MikeMcPherson/HEDGE2-OBC/CAD/CM4-spacer.FCStd

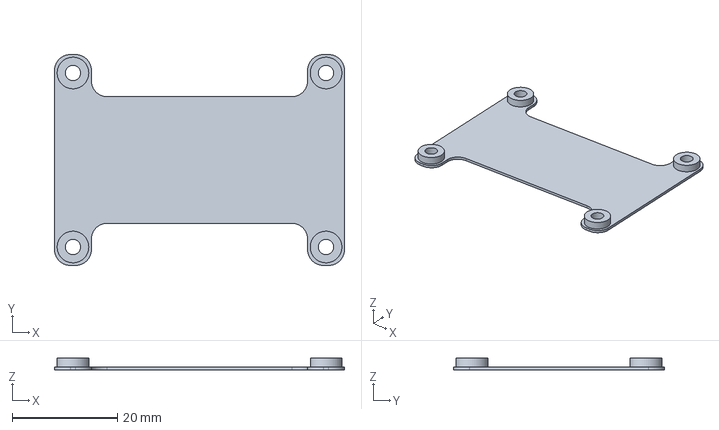
[picture p1: CAD file, 2026-04-15]
CAD/CM4-spacer.FCStd
55.0 x 40.0 x 2.30 mm
