MikeMcPherson/HEDGE2-OBC/(list of files, cad)

Other CAD files:
CAD/CM4-spacer.3mf
CAD/CM4-spacer.stl
