MikeMcPherson/HEDGE2-OBC/HEDGE2-OBC.kicad_pcb

## KiCad design HEDGE2-OBC.kicad_pcb (2025-12-07)

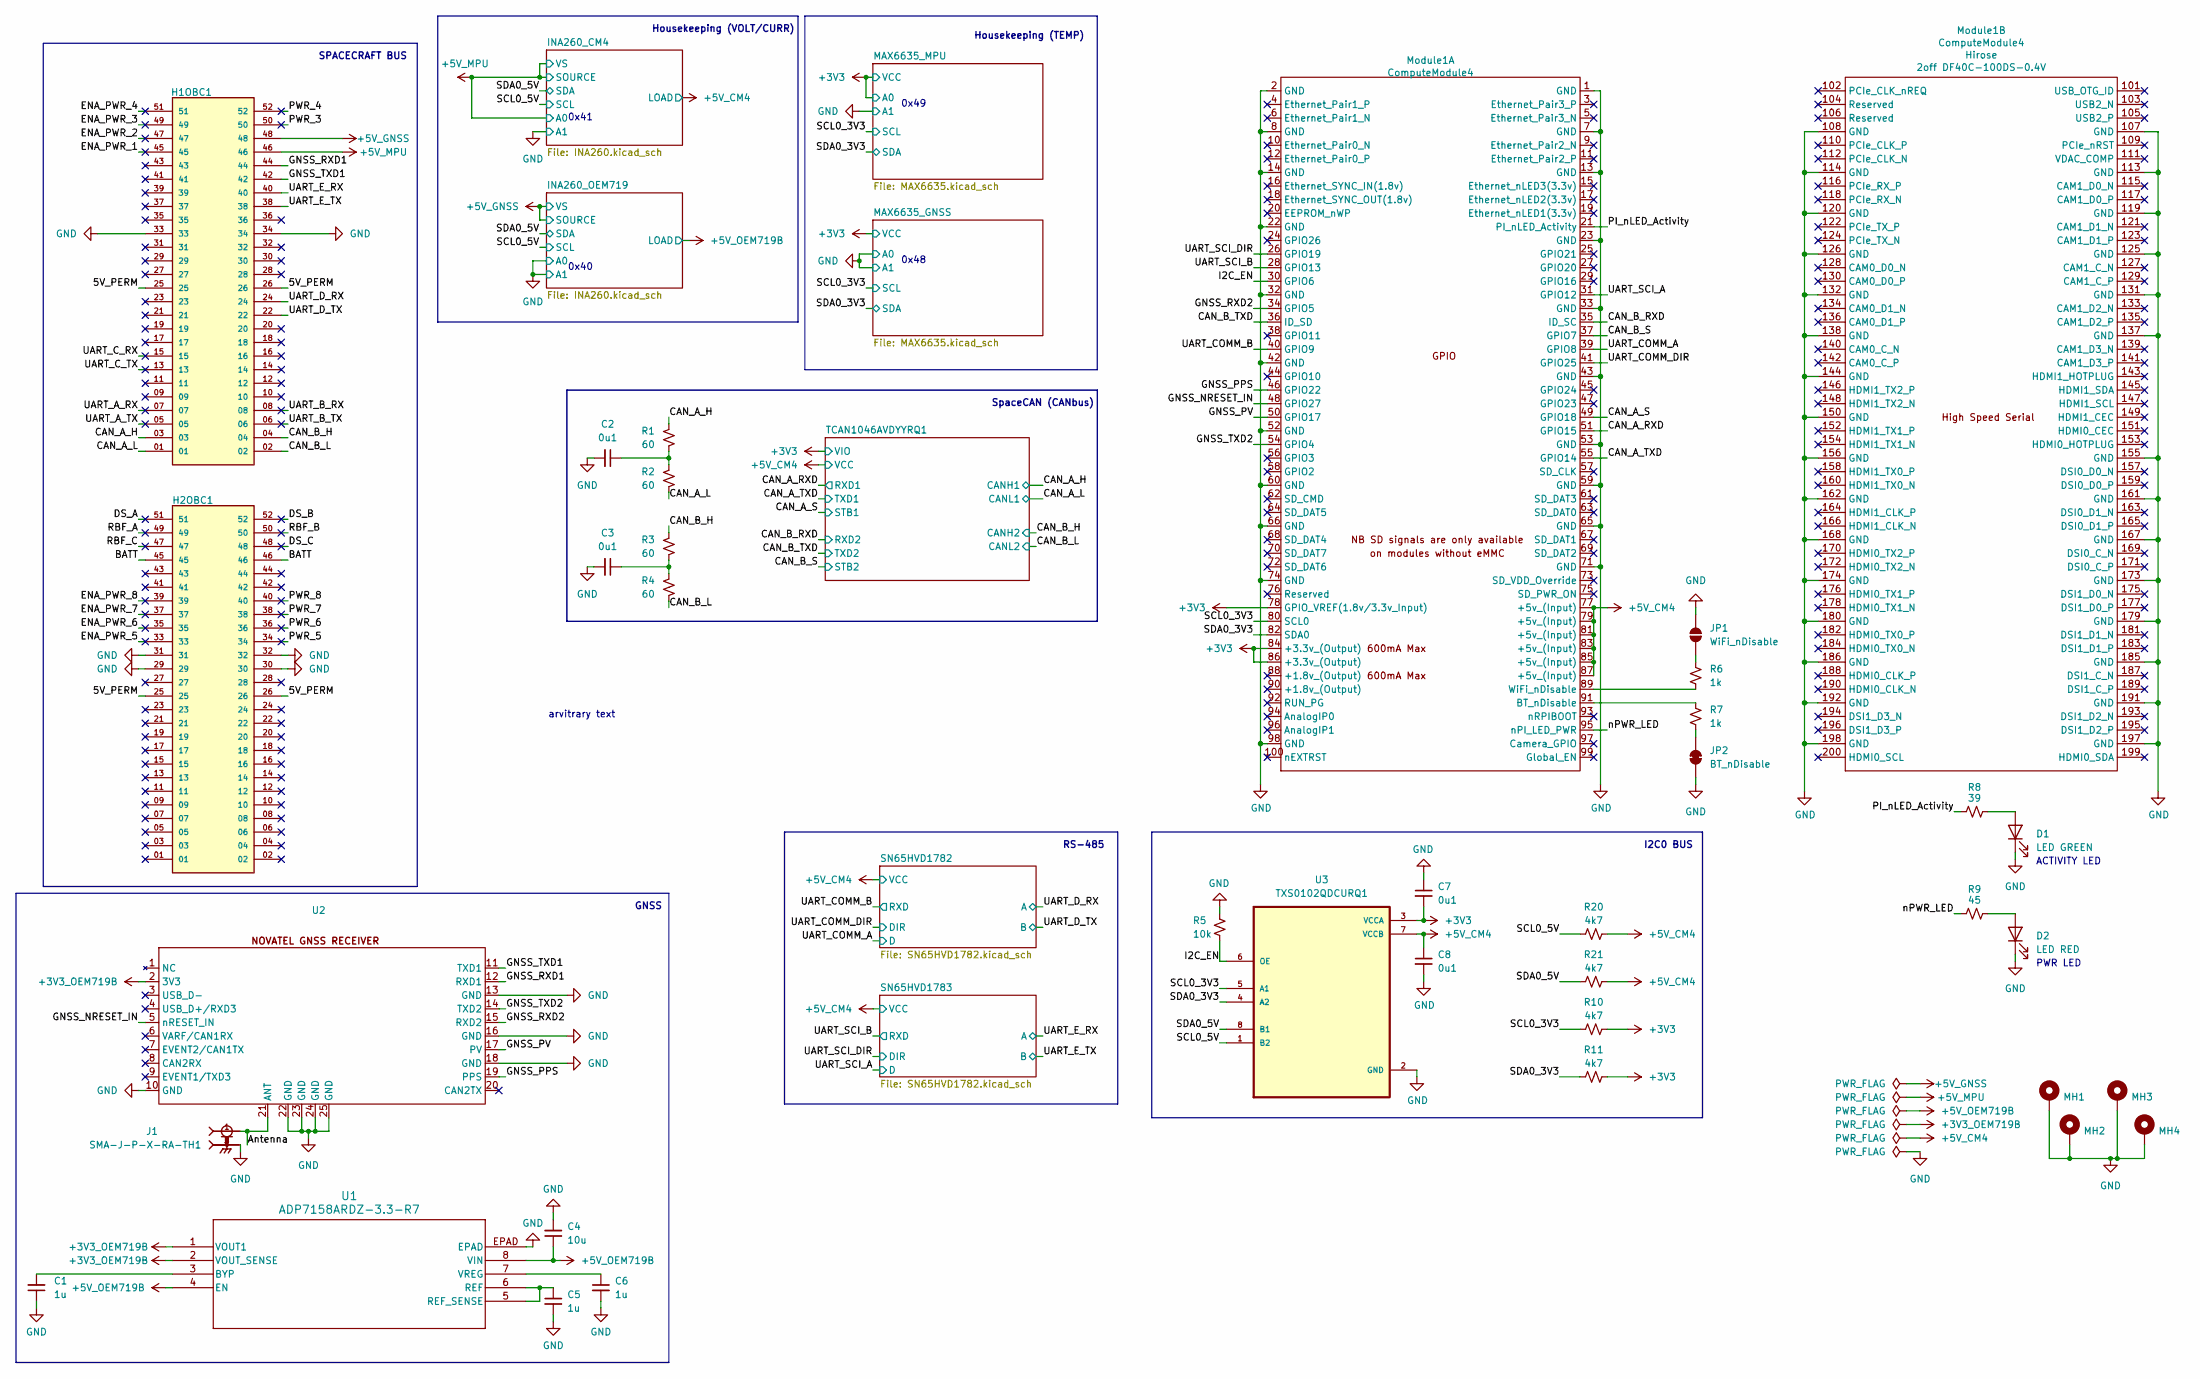
[picture p2: schematic HEDGE2-OBC.kicad_sch, HEDGE-2 OBC]

Parts:
C1, C5, C6: 1u; C_0805_2012Metric; DigiKey Part Number 1276-1029-1-ND
C2, C3, C7, C8: 0u1; C_0805_2012Metric; DigiKey Part Number 720-GA0805Y104JXABT31GCT-ND
C4: 10u; C_0805_2012Metric
D1: LED GREEN; LED_0805_2012Metric; DigiKey Part Number 160-1179-1-ND
D2: LED RED; LED_0805_2012Metric; DigiKey Part Number 160-1427-1-ND
H1OBC1, H2OBC1: Conn_02x26_Odd_Even; SAMTEC_ESQ-126-39-G-D; Manufacturer_Part_Number ESQ-126-39-G-D; Mouser Part Number 200-ESQ12639GD
J1: SMA-J-P-X-RA-TH1; SAMTEC_SMA-J-P-X-RA-TH1; PARTREV K; DigiKey Part Number SAM8856-ND
JP1: WiFi_nDisable; SolderJumper-2_P1.3mm_Open_RoundedPad1.0x1.5mm
JP2: BT_nDisable; SolderJumper-2_P1.3mm_Bridged2Bar_RoundedPad1.0x1.5mm
MH1, MH2, MH3, MH4: MountingHole_Pad; MountingHole_3.2mm_M3_Pad_Via
Module1: ComputeModule4; MODULE_CM4102008; Part Description 100 Position Connector Receptacle, Cent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; DigiKey Part Number 26-DF40HC(3.0)-100DS-0.4V(51)CT-ND
R1, R2, R3, R4: 60; R_0805_2012Metric; DigiKey Part Number RMCF0805FT60R4CT-ND
R5: 10k; R_0805_2012Metric; DigiKey Part Number 541-10.0KCCT-ND
R6, R7: 1k; R_0805_2012Metric; DigiKey Part Number 541-1.00KCCT-ND
R8: 39; R_0805_2012Metric; DigiKey Part Number P39ACT-ND
R9: 45; R_0805_2012Metric; DigiKey Part Number 311-45.3CRCT-ND
R10, R11, R20, R21: 4k7; R_0805_2012Metric; DigiKey Part Number 541-4131-1-ND
U1: ADP7158ARDZ-3.3-R7; ADP7158ARDZ-3.3-R7_ADI; DigiKey Part Number 505-ADP7158ARDZ-3.3-R7CT-ND
U2: OEM719B
U3: TXS0102QDCURQ1; SOP50P310X90-8N; DigiKey Part Number 296-37938-1-ND

Connections:
+3V3: C7.2, Module1.78 (GPIO_VREF(1.8v/3.3v_Input)), Module1.84 (+3.3v_(Output)), Module1.86 (+3.3v_(Output)), R10.2, R11.2, U3.3 (VCCA); also elsewhere on the board
+3V3_OEM719B: U1.1 (VOUT1), U1.2 (VOUT_SENSE), U2.2 (3V3)
+5V_CM4: C8.1, Module1.77 (+5v_(Input)), Module1.79 (+5v_(Input)), Module1.81 (+5v_(Input)), Module1.83 (+5v_(Input)), Module1.85 (+5v_(Input)), Module1.87 (+5v_(Input)), R20.2, R21.2, U3.7 (VCCB); also elsewhere on the board
+5V_GNSS: H1OBC1.48; also elsewhere on the board
+5V_MPU: H1OBC1.46; also elsewhere on the board
+5V_OEM719B: C4.1, U1.4 (EN), U1.8 (VIN); also elsewhere on the board
/5V_PERM: H1OBC1.25, H1OBC1.26, H2OBC1.25, H2OBC1.26
/Antenna: J1.1, U2.21 (ANT)
/BATT: H2OBC1.45, H2OBC1.46
/CAN_A_H: H1OBC1.03, R1.1; also elsewhere on the board
/CAN_A_L: H1OBC1.01, R2.2; also elsewhere on the board
/CAN_A_RXD: Module1.51 (GPIO15); also elsewhere on the board
/CAN_A_S: Module1.49 (GPIO18); also elsewhere on the board
/CAN_A_TXD: Module1.55 (GPIO14); also elsewhere on the board
/CAN_B_H: H1OBC1.04, R3.1; also elsewhere on the board
/CAN_B_L: H1OBC1.02, R4.2; also elsewhere on the board
/CAN_B_RXD: Module1.35 (ID_SC); also elsewhere on the board
/CAN_B_S: Module1.37 (GPIO7); also elsewhere on the board
/CAN_B_TXD: Module1.36 (ID_SD); also elsewhere on the board
/DS_A: H2OBC1.51
/DS_B: H2OBC1.52
/DS_C: H2OBC1.48
/ENA_PWR_1: H1OBC1.45
/ENA_PWR_2: H1OBC1.47
/ENA_PWR_3: H1OBC1.49
/ENA_PWR_4: H1OBC1.51
/ENA_PWR_5: H2OBC1.33
/ENA_PWR_6: H2OBC1.35
/ENA_PWR_7: H2OBC1.37
/ENA_PWR_8: H2OBC1.39
/GNSS_NRESET_IN: Module1.48 (GPIO27), U2.5 (nRESET_IN)
/GNSS_PPS: Module1.46 (GPIO22), U2.19 (PPS)
/GNSS_PV: Module1.50 (GPIO17), U2.17 (PV)
/GNSS_RXD1: H1OBC1.44, U2.12 (RXD1)
/GNSS_RXD2: Module1.34 (GPIO5), U2.15 (RXD2)
/GNSS_TXD1: H1OBC1.42, U2.11 (TXD1)
/GNSS_TXD2: Module1.54 (GPIO4), U2.14 (TXD2)
/I2C_EN: Module1.30 (GPIO6), R5.2, U3.6 (OE)
/PI_nLED_Activity: Module1.21 (PI_nLED_Activity), R8.1
/PWR_3: H1OBC1.50
/PWR_4: H1OBC1.52
/PWR_5: H2OBC1.34
/PWR_6: H2OBC1.36
/PWR_7: H2OBC1.38
/PWR_8: H2OBC1.40
/RBF_A: H2OBC1.49
/RBF_B: H2OBC1.50
/RBF_C: H2OBC1.47
/SCL0_3V3: Module1.80 (SCL0), R10.1, U3.5 (A1); also elsewhere on the board
/SCL0_5V: R20.1, U3.1 (B2); also elsewhere on the board
/SDA0_3V3: Module1.82 (SDA0), R11.1, U3.4 (A2); also elsewhere on the board
/SDA0_5V: R21.1, U3.8 (B1); also elsewhere on the board
/UART_A_RX: H1OBC1.07
/UART_A_TX: H1OBC1.05
/UART_B_RX: H1OBC1.08
/UART_B_TX: H1OBC1.06
/UART_COMM_A: Module1.39 (GPIO8); also elsewhere on the board
/UART_COMM_B: Module1.40 (GPIO9); also elsewhere on the board
/UART_COMM_DIR: Module1.41 (GPIO25); also elsewhere on the board
/UART_C_RX: H1OBC1.15
/UART_C_TX: H1OBC1.13
/UART_D_RX: H1OBC1.24; also elsewhere on the board
/UART_D_TX: H1OBC1.22; also elsewhere on the board
/UART_E_RX: H1OBC1.40; also elsewhere on the board
/UART_E_TX: H1OBC1.38; also elsewhere on the board
/UART_SCI_A: Module1.31 (GPIO12); also elsewhere on the board
/UART_SCI_B: Module1.28 (GPIO13); also elsewhere on the board
/UART_SCI_DIR: Module1.26 (GPIO19); also elsewhere on the board
/nPWR_LED: Module1.95 (nPI_LED_PWR), R9.1
GND: C1.1, C2.2, C3.2, C4.2, C5.2, C6.2, C7.1, C8.2, D1.1 (K), D2.1 (K), H1OBC1.33, H1OBC1.34, H2OBC1.29, H2OBC1.30, H2OBC1.31, H2OBC1.32, J1.2, J1.3, J1.4, J1.5, JP1.2 (B), JP2.1 (A), MH1.1, MH2.1, MH3.1, MH4.1, Module1.1 (GND), Module1.2 (GND), Module1.7 (GND), Module1.8 (GND), Module1.13 (GND), Module1.14 (GND), Module1.22 (GND), Module1.23 (GND), Module1.32 (GND), Module1.33 (GND), Module1.42 (GND), Module1.43 (GND), Module1.52 (GND), Module1.53 (GND), Module1.59 (GND), Module1.60 (GND), Module1.65 (GND), Module1.66 (GND), Module1.71 (GND), Module1.74 (GND), Module1.98 (GND), Module1.107 (GND), Module1.108 (GND), Module1.113 (GND), Module1.114 (GND), Module1.119 (GND), Module1.120 (GND), Module1.125 (GND), Module1.126 (GND), Module1.131 (GND), Module1.132 (GND), Module1.137 (GND), Module1.138 (GND), Module1.144 (GND), Module1.150 (GND), Module1.155 (GND), Module1.156 (GND), Module1.161 (GND), Module1.162 (GND), Module1.167 (GND), Module1.168 (GND), Module1.173 (GND), Module1.174 (GND), Module1.179 (GND), Module1.180 (GND), Module1.185 (GND), Module1.186 (GND), Module1.191 (GND), Module1.192 (GND), Module1.197 (GND), Module1.198 (GND), R5.1, U1.EPAD, U2.10 (GND), U2.13 (GND), U2.16 (GND), U2.18 (GND), U2.22 (GND), U2.23 (GND), U2.24 (GND), U2.25 (GND), U3.2 (GND); also elsewhere on the board
unnamed: C2.1, R1.2, R2.1
unnamed: C3.1, R3.2, R4.1
unnamed: D1.2 (A), R8.2
unnamed: D2.2 (A), R9.2
unnamed: JP1.1 (A), R6.1
unnamed: JP2.2 (B), R7.2
unnamed: Module1.91 (BT_nDisable), R7.1
unnamed: Module1.89 (WiFi_nDisable), R6.2
unnamed: C1.2, U1.3 (BYP)
unnamed: C5.1, U1.5 (REF_SENSE), U1.6 (REF)
unnamed: C6.1, U1.7 (VREG)

Notes on the sheet:
arvitrary text
0x48
PWR LED
SpaceCAN (CANbus)
RS-485
0x49
GNSS
Housekeeping (VOLT/CURR)
I2C0 BUS
0x41
0x40
ACTIVITY LED
SPACECRAFT BUS
Housekeeping (TEMP)

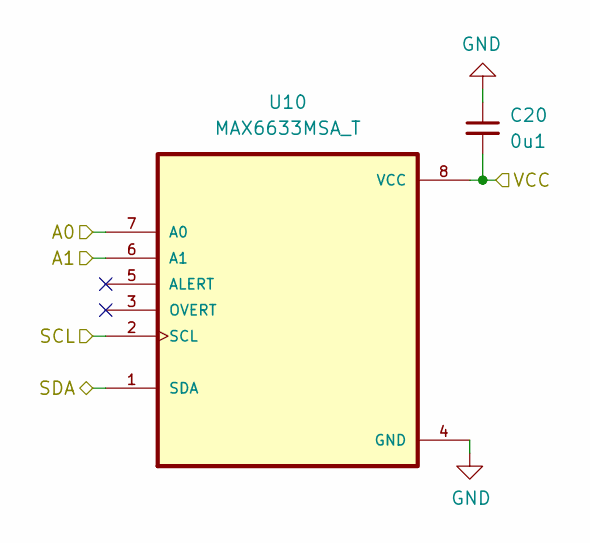
[picture p3: schematic MAX6635.kicad_sch, HEDGE-2 OBC]

Parts:
C20: 0u1; C_0805_2012Metric; DigiKey Part Number 720-GA0805Y104JXABT31GCT-ND
U10: MAX6633MSA_T; SOIC127P600X175-8N; DigiKey Part Number MAX6635MSA+TCT-ND

Connections:
+3V3: C20.2, U10.8 (VCC); also elsewhere on the board
/SCL0_3V3: U10.2 (SCL); also elsewhere on the board
/SDA0_3V3: U10.1 (SDA); also elsewhere on the board
GND: C20.1, U10.4 (GND), U10.6 (A1), U10.7 (A0); also elsewhere on the board

Parts of its further copies:
C19: 0u1; C_0805_2012Metric; DigiKey Part Number 720-GA0805Y104JXABT31GCT-ND
U9: MAX6633MSA_T; SOIC127P600X175-8N; DigiKey Part Number MAX6635MSA+TCT-ND

Connections of its further copies:
+3V3: C19.2, U9.7 (A0), U9.8 (VCC); also elsewhere on the board
/SCL0_3V3: U9.2 (SCL); also elsewhere on the board
/SDA0_3V3: U9.1 (SDA); also elsewhere on the board
GND: C19.1, U9.4 (GND), U9.6 (A1); also elsewhere on the board

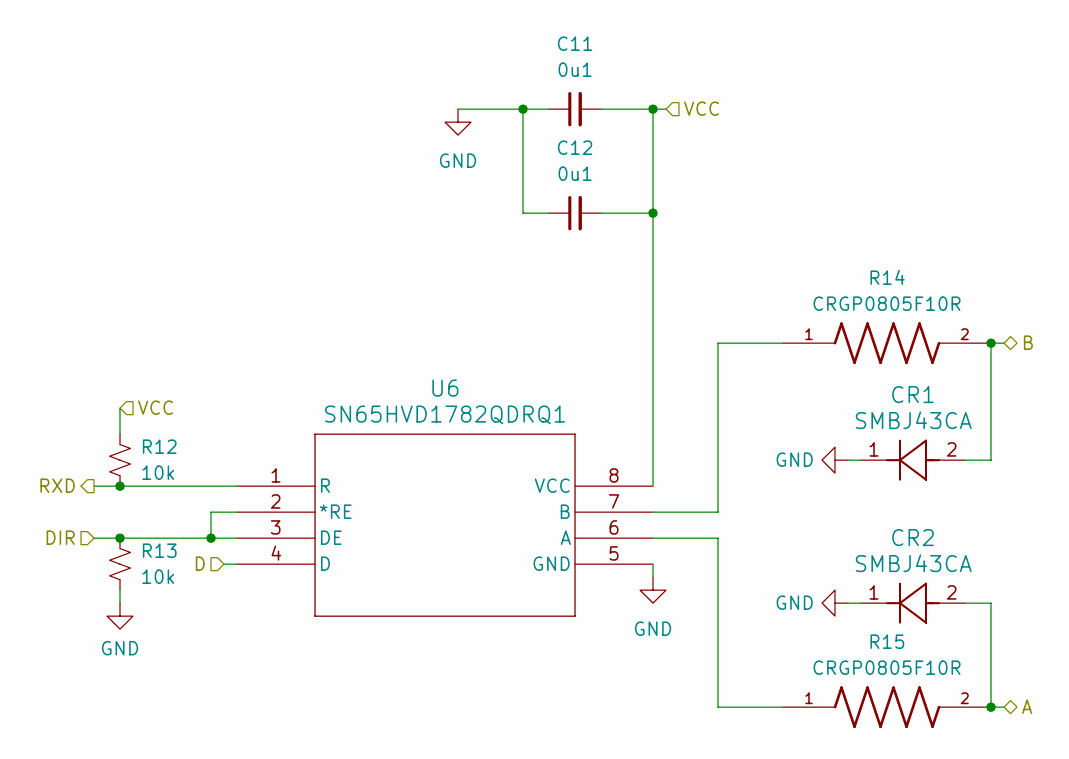
[picture p4: schematic SN65HVD1782.kicad_sch, HEDGE-2 OBC]

Parts:
C11, C12: 0u1; C_0805_2012Metric; DigiKey Part Number 720-GA0805Y104JXABT31GCT-ND
CR1, CR2: SMBJ43CA; SMBJSeries_LTF; DigiKey Part Number SMBJ43CALFCT-ND
R12, R13: 10k; R_0805_2012Metric; DigiKey Part Number 541-10.0KCCT-ND
R14, R15: CRGP0805F10R; RESC2012X65N; DigiKey Part Number A130453CT-ND
U6: SN65HVD1782QDRQ1; D8_TEX; DigiKey Part Number 296-43745-1-ND

Connections:
+5V_CM4: C11.2, C12.2, R12.1, U6.8 (VCC); also elsewhere on the board
/UART_E_RX: CR2.2, R15.2; also elsewhere on the board
/UART_E_TX: CR1.2, R14.2; also elsewhere on the board
/UART_SCI_A: U6.4 (D); also elsewhere on the board
/UART_SCI_B: R12.2, U6.1 (R); also elsewhere on the board
/UART_SCI_DIR: R13.1, U6.2 (*RE), U6.3 (DE); also elsewhere on the board
GND: C11.1, C12.1, CR1.1, CR2.1, R13.2, U6.5 (GND); also elsewhere on the board
unnamed: R15.1, U6.6 (A)
unnamed: R14.1, U6.7 (B)

Parts of its further copies:
C13, C14: 0u1; C_0805_2012Metric; DigiKey Part Number 720-GA0805Y104JXABT31GCT-ND
CR3, CR4: SMBJ43CA; SMBJSeries_LTF; DigiKey Part Number SMBJ43CALFCT-ND
R16, R17: 10k; R_0805_2012Metric; DigiKey Part Number 541-10.0KCCT-ND
R18, R19: CRGP0805F10R; RESC2012X65N; DigiKey Part Number A130453CT-ND
U7: SN65HVD1782QDRQ1; D8_TEX; DigiKey Part Number 296-43745-1-ND

Connections of its further copies:
+5V_CM4: C13.2, C14.2, R16.1, U7.8 (VCC); also elsewhere on the board
/UART_COMM_A: U7.4 (D); also elsewhere on the board
/UART_COMM_B: R16.2, U7.1 (R); also elsewhere on the board
/UART_COMM_DIR: R17.1, U7.2 (*RE), U7.3 (DE); also elsewhere on the board
/UART_D_RX: CR4.2, R19.2; also elsewhere on the board
/UART_D_TX: CR3.2, R18.2; also elsewhere on the board
GND: C13.1, C14.1, CR3.1, CR4.1, R17.2, U7.5 (GND); also elsewhere on the board
unnamed: R19.1, U7.6 (A)
unnamed: R18.1, U7.7 (B)

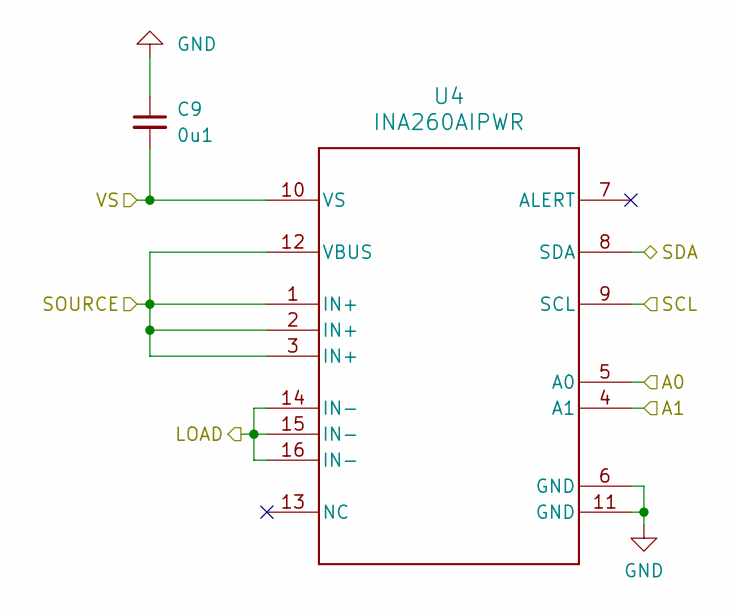
[picture p5: schematic INA260.kicad_sch, HEDGE-2 OBC]

Parts:
C9: 0u1; C_0805_2012Metric; DigiKey Part Number 720-GA0805Y104JXABT31GCT-ND
U4: INA260AIPWR; PW0016A_L; DigiKey Part Number 296-45218-5-ND

Connections:
+5V_CM4: U4.14 (IN-), U4.15 (IN-), U4.16 (IN-); also elsewhere on the board
+5V_MPU: C9.2, U4.1 (IN+), U4.2 (IN+), U4.3 (IN+), U4.5 (A0), U4.10 (VS), U4.12 (VBUS); also elsewhere on the board
/SCL0_5V: U4.9 (SCL); also elsewhere on the board
/SDA0_5V: U4.8 (SDA); also elsewhere on the board
GND: C9.1, U4.4 (A1), U4.6 (GND), U4.11 (GND); also elsewhere on the board

Parts of its further copies:
C10: 0u1; C_0805_2012Metric; DigiKey Part Number 720-GA0805Y104JXABT31GCT-ND
U5: INA260AIPWR; PW0016A_L; DigiKey Part Number 296-45218-5-ND

Connections of its further copies:
+5V_GNSS: C10.2, U5.1 (IN+), U5.2 (IN+), U5.3 (IN+), U5.10 (VS), U5.12 (VBUS); also elsewhere on the board
+5V_OEM719B: U5.14 (IN-), U5.15 (IN-), U5.16 (IN-); also elsewhere on the board
/SCL0_5V: U5.9 (SCL); also elsewhere on the board
/SDA0_5V: U5.8 (SDA); also elsewhere on the board
GND: C10.1, U5.4 (A1), U5.5 (A0), U5.6 (GND), U5.11 (GND); also elsewhere on the board

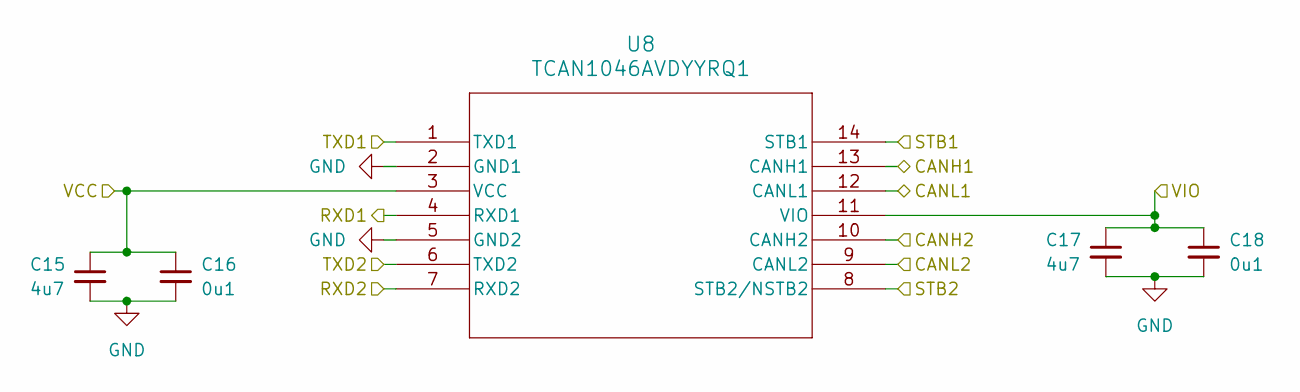
[picture p6: schematic TCAN1046V.kicad_sch, HEDGE-2 OBC]

Parts:
C15, C17: 4u7; C_0805_2012Metric; DigiKey Part Number 490-GRT21BC71H475KE13LCT-ND
C16, C18: 0u1; C_0805_2012Metric; DigiKey Part Number 720-GA0805Y104JXABT31GCT-ND
U8: TCAN1046AVDYYRQ1; SOT23_DYY_TEX; DigiKey Part Number 296-TCAN1046AVDYYRQ1CT-ND

Connections:
+3V3: C17.1, C18.1, U8.11 (VIO); also elsewhere on the board
+5V_CM4: C15.1, C16.1, U8.3 (VCC); also elsewhere on the board
/CAN_A_H: U8.13 (CANH1); also elsewhere on the board
/CAN_A_L: U8.12 (CANL1); also elsewhere on the board
/CAN_A_RXD: U8.4 (RXD1); also elsewhere on the board
/CAN_A_S: U8.14 (STB1); also elsewhere on the board
/CAN_A_TXD: U8.1 (TXD1); also elsewhere on the board
/CAN_B_H: U8.10 (CANH2); also elsewhere on the board
/CAN_B_L: U8.9 (CANL2); also elsewhere on the board
/CAN_B_RXD: U8.7 (RXD2); also elsewhere on the board
/CAN_B_S: U8.8 (STB2/NSTB2); also elsewhere on the board
/CAN_B_TXD: U8.6 (TXD2); also elsewhere on the board
GND: C15.2, C16.2, C17.2, C18.2, U8.2 (GND1), U8.5 (GND2); also elsewhere on the board

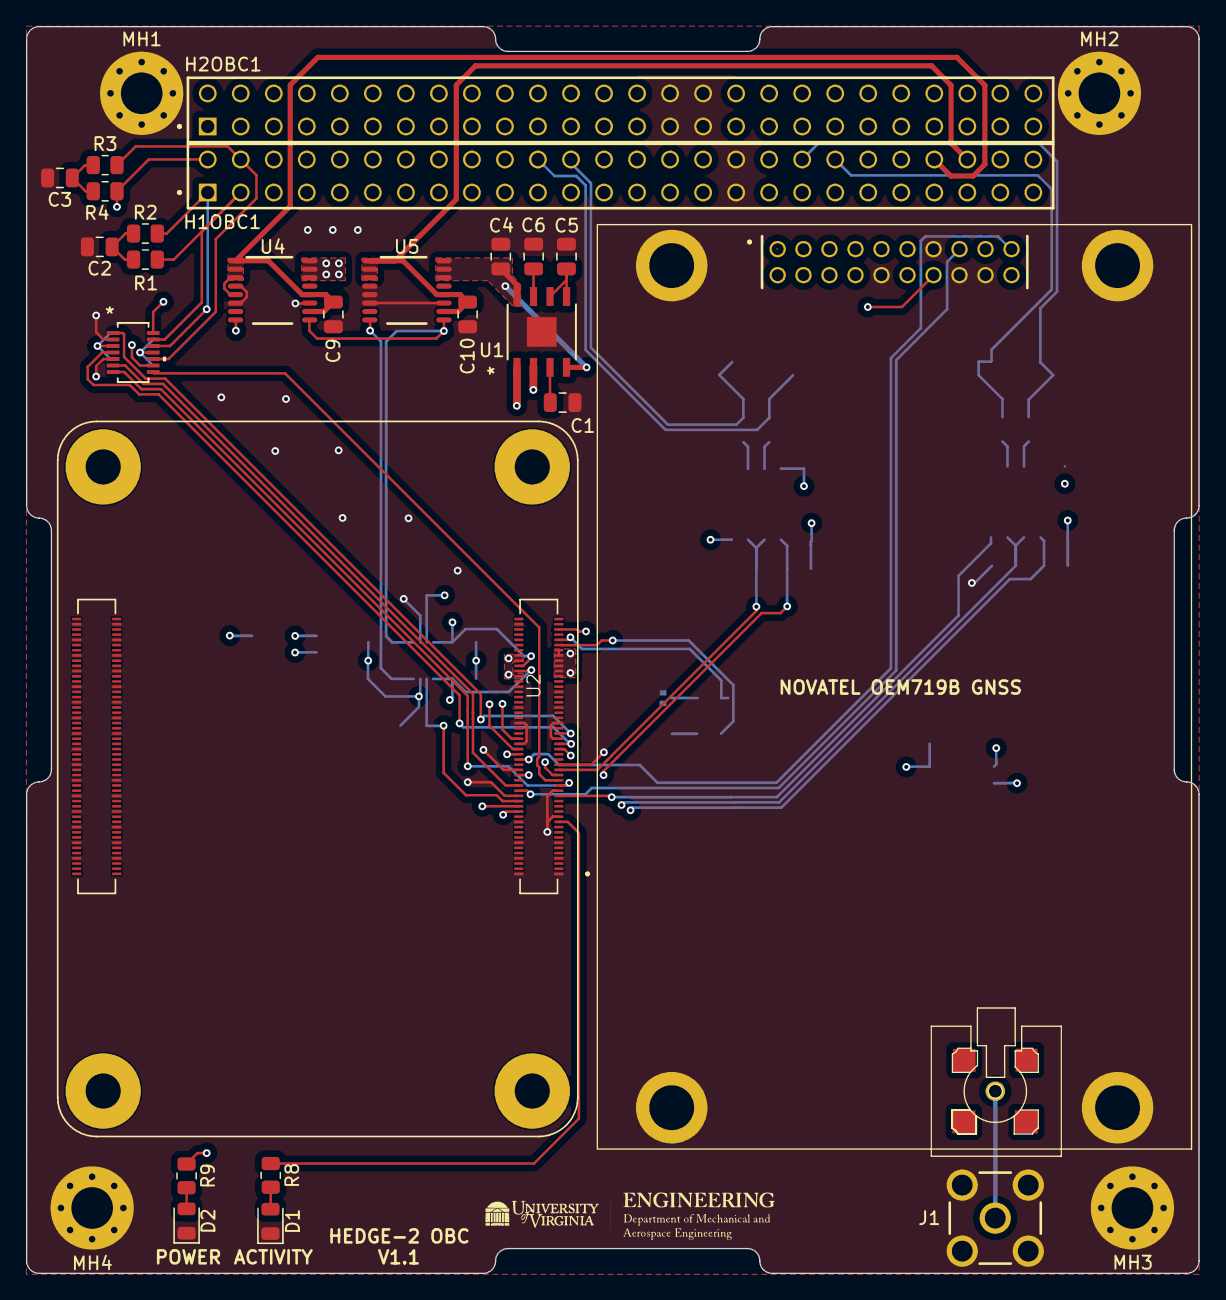
[picture p7: board HEDGE2-OBC.kicad_pcb from above]

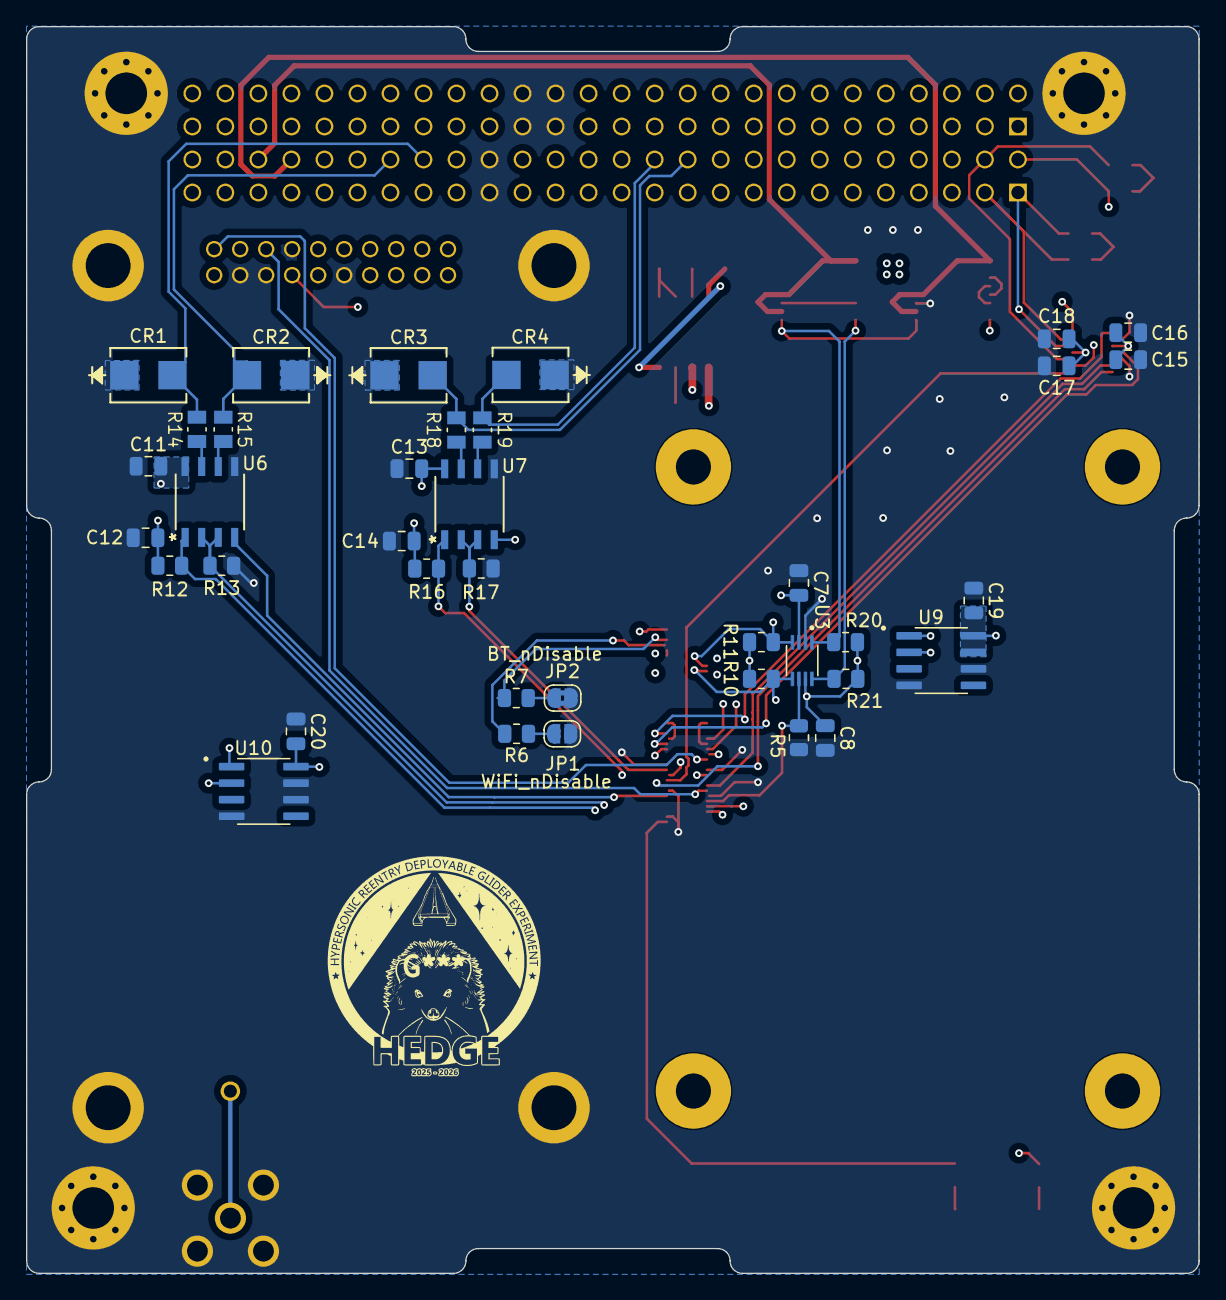
[picture p8: board HEDGE2-OBC.kicad_pcb from below]

Board: 4 copper layers, 90.2 x 95.9 mm, 67 parts (38 on the bottom side), 59 nets.
