MikeMcPherson/HEDGE2-OBC/(commit log)

2025-09-21 Start new PCB layout for second test article
    [HEDGE2-OBC.kicad_pcb, INA260.kicad_sch, SN65HVD1782.kicad_sch, TCAN1046V.kicad_sch]
2025-09-21 Add power zones on In1 and In2
    [HEDGE2-OBC.kicad_pcb]
2025-09-22 Rework Novatel OEM719B symbol and footprint
    [HEDGE2-OBC.kicad_pcb, HEDGE2-OBC.kicad_sch, INA260.kicad_sch, SN65HVD1782.kicad_sch, TCAN1046V.kicad_sch]
2025-09-22 Layout PCB; update footprints with 3D models
    [HEDGE2-OBC.kicad_pcb, HEDGE2-OBC.kicad_sch, INA260.kicad_sch, SN65HVD1782.kicad_sch, TCAN1046V.kicad_sch]
2025-09-23 Continue PCB layout
    [HEDGE2-OBC.kicad_pcb, HEDGE2-OBC.kicad_sch]
2025-09-25 Continue layout
    [HEDGE2-OBC.kicad_pcb, HEDGE2-OBC.kicad_sch]
2025-10-02 Fix MMBX footprint; resolve ERC/DRC
    [HEDGE2-OBC.kicad_pcb, HEDGE2-OBC.kicad_sch, MAX6635.kicad_sch, TCAN1046V.kicad_sch]
2025-10-02 Layout complete
    [HEDGE2-OBC.kicad_pcb]
2025-10-02 Final layout, submitted to DFM
    [HEDGE2-OBC.kicad_pcb]
2025-10-03 Add functional block labels to schematic
    [HEDGE2-OBC.kicad_sch]
2025-10-04 Online DFM satisfactory
    [HEDGE2-OBC.kicad_pcb, HEDGE2-OBC.kicad_sch]
2025-10-06 Verify CM4 and OEM710B footprints and clearances; add mounting hardware
    [HEDGE2-OBC.kicad_pcb, HEDGE2-OBC.kicad_sch]
2025-10-07 Arbitrary change for demo purposes
    [HEDGE2-OBC.kicad_sch]
2025-12-07 Fix TCAN power supply swap
    [HEDGE2-OBC.kicad_pcb, HEDGE2-OBC.kicad_sch, INA260.kicad_sch, MAX6635.kicad_sch, SN65HVD1782.kicad_sch, TCAN1046V.kicad_sch]
2026-01-11 Add cap to 3V3 LDO output; add solder jumpers; change 3V3 routing
    [HEDGE2-OBC.kicad_pcb, HEDGE2-OBC.kicad_sch]
2026-01-11 Fix solder mask on Pi connectors
    [HEDGE2-OBC.kicad_pcb]
2026-01-11 Clean up CM4 routing
    [HEDGE2-OBC.kicad_pcb, HEDGE2-OBC.kicad_sch, MAX6635.kicad_sch]
2026-01-28 Add PCM5102A I2S audio output for APRS radio
    [HEDGE2-OBC.kicad_pcb, HEDGE2-OBC.kicad_sch, INA260.kicad_sch, MAX6635.kicad_sch, SN65HVD1782.kicad_sch, TCAN1046V.kicad_sch]
2026-01-29 Add PCM and SPI UART; begin layout update
    [HEDGE2-OBC.kicad_pcb, HEDGE2-OBC.kicad_sch, INA260.kicad_sch, MAX6635.kicad_sch, SN65HVD1782.kicad_sch, TCAN1046V.kicad_sch]
2026-01-29 Continue layout update
    [HEDGE2-OBC.kicad_pcb, HEDGE2-OBC.kicad_sch, INA260.kicad_sch, MAX6635.kicad_sch, SN65HVD1782.kicad_sch, TCAN1046V.kicad_sch]
2026-02-02 Add IMU; eliminate environmental sensor; finish layout
    [HEDGE2-OBC.kicad_pcb, HEDGE2-OBC.kicad_sch, INA260.kicad_sch, SN65HVD1782.kicad_sch, TCAN1046V.kicad_sch]
2026-03-06 Final cleanup
    [HEDGE2-OBC.kicad_sch, INA260.kicad_sch, SN65HVD1782.kicad_sch, TCAN1046V.kicad_sch]
2026-03-08 Fix JP3 footprint reversal; start CAD for CM4 spacers
    [CM4-spacer.3mf, CM4-spacer.FCStd]
2026-03-08 Fix GNSS antenna grounding problem
    [CM4-spacer.3mf, CM4-spacer.FCStd]
2026-04-15 3D-printed spacer for CM4; correct UART pins in table
    [CM4-spacer.3mf, CM4-spacer.FCStd, CM4-spacer.stl, HEDGE2-OBC.kicad_sch]
